dreamster/dreamster-board/shield-basic/shield-basic-BOM.xls

Reference | Qty | Value | Description | Digikey part number | Qty needed | Qty to buy | Cost | Total
 |  |  |  |  | 30
R6 | 1 | 10 | RES SMD 10 OHM 5% 0.4W 0805 | RHM10KDKR-ND | 30 | 30 | 0.05440 | 1.632
R7, R8, R10 | 3 | 100 | RES SMD 100 OHM 5% 1/8W 0805 | P100ACT-ND | 90 | 100 | 0.01490 | 1.490
L1, L2 L3 | 3 | 1 uH | FIXED IND 1UH 800MA 190 MOHM SMD | 490-4992-1-ND | 90 | 100 | 0.18330 | 18.330
C8 | 1 | 10 uF | CAP CER 10UF 16V 10% X5R 0805 | 490-3886-1-ND | 30 | 50 | 0.10380 | 5.190
C2, C4, C6, C9, C13, C14, C15 | 7 | 100 nF | CAP CER 0.1UF 16V 10% X7R 0805 | 399-1167-1-ND | 210 | 250 | 0.03000 | 7.500
R1, R2, R3, R9, R11, R12, R13 | 7 | 10k | RES SMD 10K OHM 5% 1/8W 0805 | P10KACT-ND | 210 | 250 | 0.01104 | 2.760
RV1, Rv2, Rv3 | 3 | 10k | TRIMMER 10K OHM 0.05W SMD | 490-6999-1-ND | 90 | 100 | 0.19050 | 19.050
C11 | 1 | 10n | CAP CER 10000PF 16V 10% X7R 0805 | 399-7995-1-ND | 30 | 50 | 0.11260 | 5.630
C1, C3 | 2 | 18n | CAP CER 0.018UF 50V 10% X7R 0805 | 399-1162-1-ND | 60 | 60 | 0.06460 | 3.876
R4, R5 | 2 | 2.2k | RES SMD 2.2K OHM 5% 1/8W 0805 | 1276-5537-1-ND | 60 | 100 | 0.00840 | 0.840
C10 | 1 | 2.2u | CAP CER 2.2UF 10V 10% X7R 0805 | 587-1286-1-ND | 30 | 50 | 0.06320 | 3.160
C12 | 1 | 220u | CAP ALUM 220UF 16V 20% SMD | 399-6679-1-ND | 30 | 30 | 0.29600 | 8.880
C5 | 1 | 3.3 uF | CAP CER 3.3UF 10V 10% X5R 0805 | 399-3129-1-ND | 30 | 50 | 0.11700 | 5.850
C7 | 1 | 47n | CAP CER 0.047UF 50V 10% X7R 0805 | 399-1166-1-ND | 30 | 50 | 0.03180 | 1.590
U5 | 1 | ARDUINO_SHIELD | CONN RCPT .100" |  | 30 |  |  | 0.000
D2 | 1 | CD1206-S01575 | DIODE GEN PURP 100V 150MA 1206 | CD1206-S01575CT-ND | 30 | 30 | 0.12880 | 3.864
P6, P7 | 2 | CONN_01X02 | CONN HEADER .100 2POS |  | 60 |  |  | 0.000
P1, P2, P3, P4, P5 | 5 | CONN_01X04 | CONN RCPT .100" |  | 150 |  |  | 0.000
P8 | 1 | CONN_01X06 | CONN RCPT .100" |  | 30 |  |  | 0.000
IC1 | 1 | DRV8833 | IC MOTOR DRIVER PAR 16HTSSOP | 296-29434-1-ND | 30 | 30 | 2.20600 | 66.180
D1 | 1 | LED_RGB_A | LED RED/GREEN/BLUE PLCC6 SMD | CLV6A-FKB-CK1P1G1BB7R3R3TR-ND | 30 | 30 | 0.75000 | 22.500
U2 | 1 | LM386 | IC AMP AUDIO PWR .325W AB 8VSSOP | LM386MMX-1/NOPBCT-ND | 30 | 30 | 0.78800 | 23.640
Q2 | 1 | NPN | Transistors_SMD:sot23 |  | 30 |  |  | 0.000
Q1 | 1 | PNP | Transistors_SMD:sot23 |  | 30 |  |  | 0.000
CON1 | 1 | SD_Card | CONN SD CARD PUSH-PUSH R/A SMD | DM1AA-SF-PEJ(21) | 30 | 30 | 3.41240 | 102.372
P9 | 1 | speaker | CONN HEADER .100 2POS |  | 30 | 30 |  | 0.000
SW1 | 1 | SW_PUSH | SWITCH PUSH SPST-NO 0.1A 32V | 401-1985-ND | 30 | 30 | 0.73000 | 21.900
U3, U4 | 2 | TCRT1000 | SENSOR OPTO TRANS 4MM REFL THPCB | 751-1031-ND | 60 | 60 | 0.73480 | 44.088
U1, U19 | 2 | TL082 | IC OPAMP JFET 3MHZ 8SOIC | 296-1284-1-ND | 60 | 60 | 0.51040 | 30.624
 |  |  |  |  |  |  | Total amount to pay | 400.946
 |  |  |  |  |  |  | Total per board | 13.365
