dreamster/dreamster-board/shield-basic/shield-basic.kicad_pcb

## KiCad design shield-basic/shield-basic.kicad_pcb (2015-02-26)

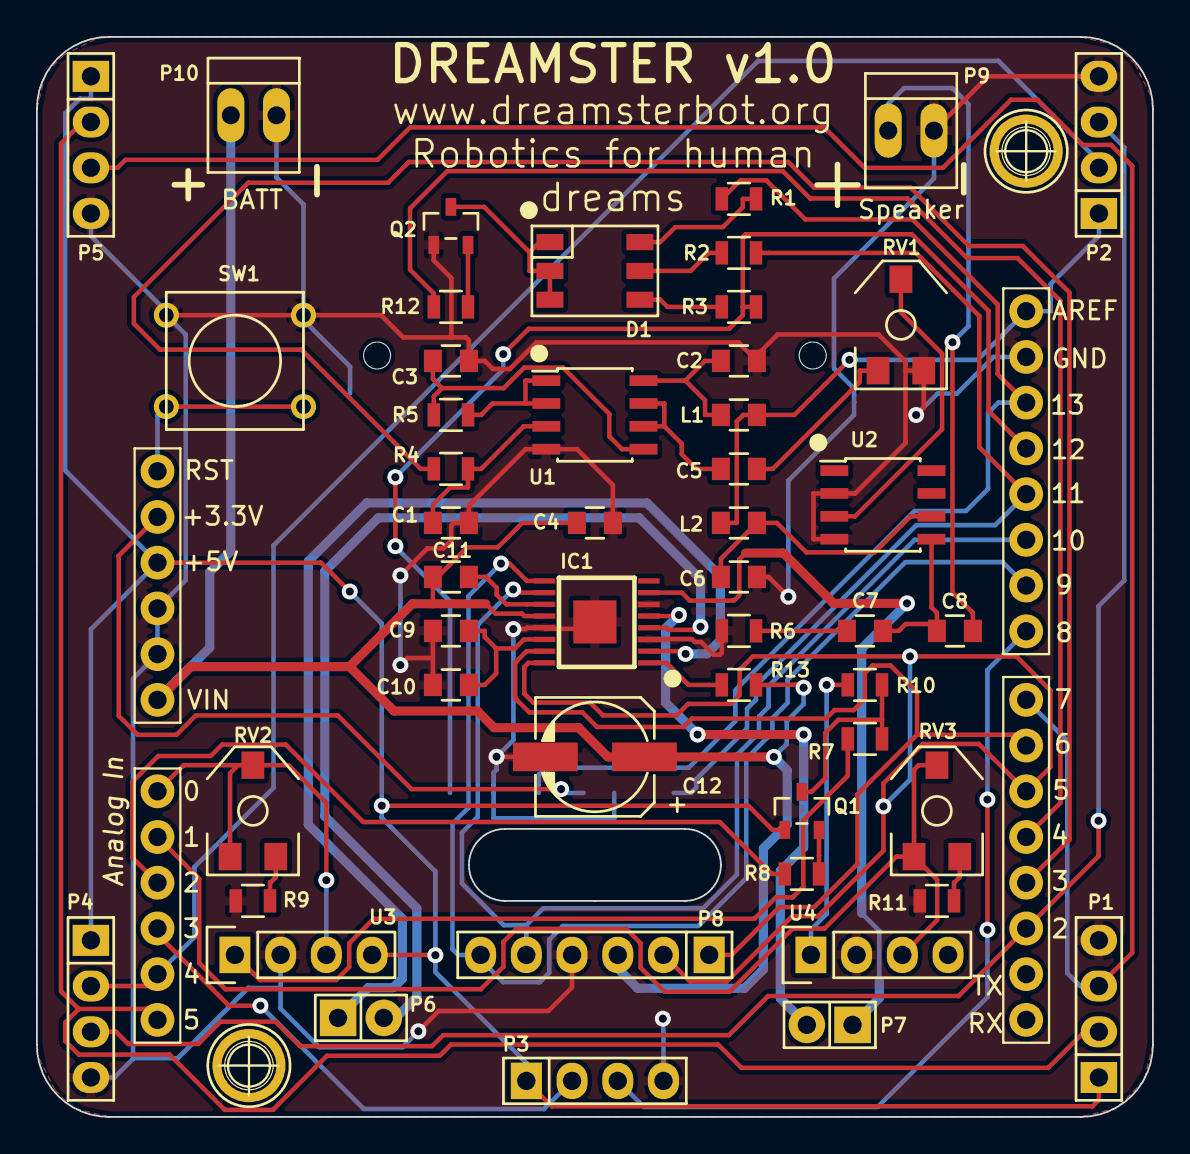
[picture p1: board shield-basic.kicad_pcb from above]

Board: 2 copper layers, 62.0 x 60.0 mm, 53 parts (1 on the bottom side), 52 nets.

Parts:
C1, C3: 18n; C_0805
C2, C6: 100 nF; C_0805
C4, C9: 100n; C_0805
C5: 3.3 uF; C_0805
C7: 47n; C_0805
C8: 10 uF; C_0805
C10: 2.2u; C_0805
C11: 10n; C_0805
C12: 220u; c_elec_6.3x7.7
CON1: SD_Card; SD_Card_Receptacle
D1: LED_RGB_A; rgb_led_plcc6
IC1: DRV8833; drv8833
L1, L2: 1 uH; C_0805
P1, P2, P3, P4, P5: CONN_01X04; Socket_Strip_Straight_1x04
P6, P7: CONN_01X02; Socket_Strip_Straight_1x02
P8: CONN_01X06; Socket_Strip_Straight_1x06
P9: Speaker; PINHEAD1-2
P10: CONN_01X02; PINHEAD1-2
P11, P12: CONN_01X01; 1pin
Q1: BC857; sot23
Q2: BC847; sot23
R1, R2, R3, R12: 10k; R_0805
R4, R5: 2.2k; R_0805
R6: 10; R_0805
R7, R8, R9, R10, R11: 100; R_0805
R13: 47k; R_0805
RV1, RV2, RV3: 10k; POT_SMD
SW1: SW_PUSH; SW_PUSH_SMALL
U1: TL082; SOIC-8_3.9x4.9mm_Pitch1.27mm
U2: LM386; SOIC-8_3.9x4.9mm_Pitch1.27mm
U3, U4: TCRT1000; Socket_Strip_Straight_1x04
U5: ARDUINO_SHIELD; arduino_shield

Connections:
+3V3: CON1.4, U5.3.3V
+5VD: L1.1, L2.1, P1.1, P2.1, P3.1, P4.1, P5.1, Q1.1, U3.4, U4.4, U5.5V, U5.AREF
+BATT: C4.1, C11.2, C12.1, IC1.12, P8.3, P10.1, R13.1, U5.VIN
/BLUE: CON1.5, R1.1, U5.D13
/ECHO_A: P3.3, U5.D8
/ECHO_B: P2.3, P4.3, U5.D2
/ECHO_C: P1.3, P5.3, U5.D7
/GREEN: CON1.2, R2.1, U5.D11
/LED_enable: R12.1, U5.D4
/RED: CON1.7, R3.1, U5.D12
/RESET: SW1.1, U5.RES
/TRG_A: P3.2, U5.A3
/TRG_B: P2.2, P4.2, U5.A4
/TRG_C: P1.2, P5.2, U5.A5
/hbridge/LM+: IC1.7, P7.1
/hbridge/LM-: IC1.5, P7.2
/hbridge/LMI1: IC1.9, P8.6, U5.D9
/hbridge/LMI2: IC1.10, P8.5, U5.D10
/hbridge/RM+: IC1.2, P6.1
/hbridge/RM-: IC1.4, P6.2
/hbridge/RMI1: IC1.16, P8.2, U5.D5
/hbridge/RMI2: IC1.15, P8.1, U5.D6
/irsensor/LSENS: RV2.1, RV2.2, U3.3, U5.A0
/irsensor/RSENS: RV3.1, RV3.2, U4.3, U5.A1
/irsensor/~EMITTER: R8.2, U5.A2
/sound/In: R4.2, U5.D3
GND: C1.2, C2.2, C3.2, C4.2, C6.2, C9.2, C10.2, C12.2, CON1.3, CON1.6, CON1.12, CON1.13, IC1.3, IC1.6, IC1.13, P1.4, P2.4, P3.4, P4.4, P5.4, P8.4, P9.2, P10.2, Q2.1, R6.2, R9.2, R11.2, RV1.3, SW1.2, U1.4, U2.2, U2.4, U3.2, U4.2, U5.GND@
unnamed: C1.1, R4.1, U1.3
unnamed: C2.1, L1.2, U1.8
unnamed: C3.1, R5.1, U1.5
unnamed: C5.1, U1.6, U1.7
unnamed: C5.2, RV1.1
unnamed: C6.1, L2.2, U2.6
unnamed: C7.1, C8.1, U2.5
unnamed: C7.2, R6.1
unnamed: C8.2, P9.1
unnamed: C9.1, C10.1, IC1.14
unnamed: C11.1, IC1.11
unnamed: D1.1, D1.2, D1.3, Q2.3
unnamed: D1.4, R3.2
unnamed: D1.5, R2.2
unnamed: D1.6, R1.2
unnamed: IC1.1, R13.2
unnamed: Q1.2, R8.1
unnamed: Q1.3, R7.1, R10.1
unnamed: Q2.2, R12.2
unnamed: R5.2, U1.1, U1.2
unnamed: R7.2, U3.1
unnamed: R9.1, RV2.3
unnamed: R10.2, U4.1
unnamed: R11.1, RV3.3
unnamed: RV1.2, U2.3
