dreamster/dreamster-board/(threads)

Thread 1 (2015-01-26):

Switch to DRV8833C h bridge

yagui, 2015-01-26:
Check the schematics of www.bananarobotics.com module and find out what's the porpoise of serverl resistor and capacitors. Check if they are needed in dreamster-shield.

tulku, 2015-02-07:
This one depends on #5.

tulku, 2015-02-07:
In #5 we decided to switch to the DRV8833C h bridge. I'm updating this issue to reflect that.

Closed 2015-02-23.

Thread 2 (2015-01-26):

Check TCR1000 in dreamster-shield

yagui, 2015-01-26:
Check the connections of TCR1000 on dreamster-shield schematic. It was copied from CdR Tito project. Discuss how it works and if there is no missing components

Martin-MT, 2015-02-02:
I believe there are no missing components.
It only needs a resistor to generate a voltage proportional to the current going through the phototransistor

Closed 2015-02-02.

Thread 3 (2015-02-06):

Add RGB leds to the board

tulku, 2015-02-06:
We wanted to have some LEDs to allow easily debugging.

We thought of having LEDs in parallel to save pins but still have enough lights to make it nice.

yagui, 2015-02-07:
any suggestion? I don't know any popular RGB led

tulku, 2015-02-07:
@sebascerone can we re use the LED that we use in LESS boards? Which one is it?

sebascerone, 2015-02-07:
I don't think so, digikey just send me an email tell me it is deprecated.
Why don'y we use just SMD LED?

Regards,
Sebastian

2015-02-07 14:48 GMT-03:00 tulku <notifications@github.com>:

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

tulku, 2015-02-07:
I don't understand... I guess that Ariel wants the specific LED so that he
can check currents, and connections... And not just if it is SMD or DIP...

"Oh no, not again."

- A bowl of petunias on its way to certain death.

On Sat, Feb 7, 2015 at 2:54 PM, sebascerone <notifications@github.com>
wrote:

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

Closed 2015-02-23.

Thread 4 (2015-02-06):

Add sound to dreamster

tulku, 2015-02-06:
Having sound could be nice. In the current dream-sheild version, can we easily add something to reproduce sounds (like human voice, recorded mp3s)?

Please take into account that we can just hack one or two robots and not add sound to all the robots.

tulku, 2015-02-07:
To add audio, we could put an stereo audio codec and an SD reader. We don't need to decode MP3, that circuito wouldn't be so complex nor expensive.

Something like this could be use to read the SD:
https://learn.adafruit.com/adafruit-micro-sd-breakout-board-card-tutorial

And something like this to use as Stereo Audio CODEC:
http://ar.mouser.com/Search/Refine.aspx?Keyword=WM8731

There is a board from which we can copy schematics and library:
https://www.sparkfun.com/products/11290
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

The board seems to be based in this project: http://wiki.openmusiclabs.com/wiki/AudioCodecShield

tulku, 2015-02-07:
It seems, according to @ernestmc that the output power of this IC will not drive a speaker. We should add some aplification stage to make it louder.

yagui, 2015-02-07:
I dont understand what is the goal.

We want to add sound to some boars but not all?
It should be in the dreamster shield schematics and we solder it just in a few? or is an extra board that we could add in some prototypes?

We want microphone AND recorded sound? or is one or the other.

If we gonna put an SD, I wouldn't use a codec. I'd just save raw sound, and simplify the circuit.

tulku, 2015-02-07:
If we can make it simple and cheap enough it would be nice to put it on every board, if not just a few.

I think that having the footprints in the board and use them or not is better than having an add on board.

I like your idea... Just store the samples in the SD, output PWM, filter and then use a simple amplifier?

Could you add that to the schematics?

yagui, 2015-02-14:
if we use a SD card we need 4 pins for spi. Do we have other options?

tulku, 2015-02-15:
I don't think so. We do not have those pins?

"Oh no, not again."

- A bowl of petunias on its way to certain death.

On Sat, Feb 14, 2015 at 12:56 PM, Ariel Burman <notifications@github.com>
wrote:

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

yagui, 2015-02-16:
we are one pin short.
maybe we can leave the ir sensor's leds always on.

tulku, 2015-02-16:
@Martin-MT thought that this was a bad idea, but I don't remember why.

yagui, 2015-02-16:
ok, we can share a pin. The leds enable of ir sensors and mosi (cmd) line of the sd. When using the ir sensors the ChipSelect line of the sd should be disabled. When using the SD, the led of ir sensor will flash randomly. If we do not make readings of the sensors while using the SD, I think it will be ok. What do you think?

ernestmc, 2015-02-16:
Just one word: BUS. Make the IR sensors and all other sensors work independently with a small dedicated uP that magages the polling on pogrammable intervals or otherwise. Another benefit of this approach is that you can make them separate pluglable modules.

yagui, 2015-02-16:
It's getting complicated. I think this first version should be simple. What if we forget about the SD card and generate simple sounds like tones?

tulku, 2015-02-16:
Ok. I like the idea of sharing the Pin. We will not have an sd reader per
robot, so we will be generating tones for most of them. In the ones that we
want to have proper sounds, we can share the pin.

Lucas

"Oh no, not again."

- A bowl of petunias on its way to certain death.

On Mon, Feb 16, 2015 at 1:35 PM, Ariel Burman <notifications@github.com>
wrote:

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

Closed 2015-02-23.

Thread 5 (2015-02-07):

Do we want to use the L9110 h bridge?

tulku, 2015-02-07:
The H-bridge present in the most common "arduino driver for motors" is the L9110. That IC is no were to be found, execpt in Alibaba, where it is incredible cheap:

http://www.alibaba.com/product-detail/L9110-L9110S_60135131276.html

@yagui, @sebascerone Will we be able to source the components? Shall we use a more trusty part? Switch to a TI h bridge?

sebascerone, 2015-02-07:
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
We should use LMD18200 from TI. It is the same I used for TCO.

Regards,
Sebastian

yagui, 2015-02-07:
DRV8833C looks about similar to L9110 and is one of the least expensive in ti webpage
http://www.ti.com/product/DRV8833C
$2.24 or $0.8 | 1ku

LMD18200 has more output current, it says 12V operation, and is more expensive
$17.01 or $8.10 | 1ku
www.ti.com/product/LMD18200
If we want more current rate there other options in ti web
http://www.ti.com/product/drv8848
is a good option or
http://www.ti.com/product/drv8841
another one

sebascerone, 2015-02-07:
Forget LMD 18200, it is a lot of money!!!

2015-02-07 10:33 GMT-03:00 Ariel Burman <notifications@github.com>:

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

tulku, 2015-02-07:
@sebascerone  what do you thing, DRV8833C or L9110? The TI one seems cheap enough and I would think that it's more reliable.

sebascerone, 2015-02-07:
I always prefer texas than a chinese IC.

2015-02-07 14:52 GMT-03:00 tulku <notifications@github.com>:

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

tulku, 2015-02-07:
Ok, then we switch to the DRV8833C.

Closed 2015-02-07.

Thread 10 (2015-02-23):

connector for h-bridge replacement

yagui, 2015-02-23:
The connector 6 is for when one want to use the Chinese L9110 h-bridge.
In that case, I think the actual position puff the connector hides a trimmer.
The connector can be moved a little too the right.

yagui, 2015-02-23:
also should be checked that is correctly oriented, or if it should be rotated 180 degrees

yagui, 2015-02-23:
the orientation its ok. no need to rotate.

Closed 2015-02-25.

Thread 6 (2015-02-23):

Gnd plane

yagui, 2015-02-23:
The h-bridge needs a Gnd plane for heat dissipation.
Bottom plane could be 5V, making a big capacitor and helping stability of power

Closed 2015-02-25.

Thread 7 (2015-02-23):

Connector battery

yagui, 2015-02-23:
The connector for the battery ( P10 ) should be in the edge of the pcb, in case the battery goes below the two boards

yagui, 2015-02-23:
maybe we can move the switch a little down and put this connector where is the switch now

Closed 2015-02-24.

Thread 11 (2015-02-24):

Connectors for ultrasound too close

yagui, 2015-02-24:
It seems that the hcsr-04 has 45 mm width.
http://s442.photobucket.com/user/supperman2000/media/BGA/Module%20HC-SR04/3.jpg.html
http://www.robosoftsystems.co.in/wikidocs/images/archive/8/84/20130108065629!HC-SR04.jpg

If is this correct:

- P1 and P2 (P4 and P5) should be separated at least 45 mm (47m or more is preferred) measured  from both center of pin 1. Now is 43 mm.

- P1 and P4 should be separated 45 mm measured from internal edge of the connector. Now is 38 mm.

Closed 2015-02-24.

Thread 12 (2015-02-24):

Led blocked by L9110

yagui, 2015-02-24:
In case of using L9110 (33 mm height, 20 mm width) the led will be blocked.
The led should be moved 14 mm higher.

yagui, 2015-02-24:
http://bestaccessories.info/l9110-2-channel-motor-driver-module-red-green-2-5~12v_643042.html

yagui, 2015-02-24:
Also P6 could be moved a little more to the right

Closed 2015-02-25.

Thread 15 (2015-02-25):

H-bridge power pad

yagui, 2015-02-25:
there shouldn't  be any track or via under h-bridge. It should be all Gnd plane. Tracks should come outward  of the ic.

Closed 2015-02-25.

Thread 16 (2015-02-25):

led serigraphy

yagui, 2015-02-25:
Fix Led serigraphy, so the pads don't be covered by it

Closed 2015-02-25.

Thread 17 (2015-03-25):

holes position

sebasgm, 2015-03-25:
More space for the holes is required in order to easily attach hte battery holder and the chassis.

Thread 18 (2015-03-25):

Preset footprint

sebasgm, 2015-03-25:
The preset footprint for light sensors doesn't match the physical component.

Thread 19 (2015-03-25):

LM386 footprint

sebasgm, 2015-03-25:
LM 386 footprint doesn't match the physical component.

Thread 20 (2015-03-25):

SD card holder footprint

sebasgm, 2015-03-25:
The footprint doesn't match the physical component. Some pins match but others don't and it is not so easy to figure out which is which.

Thread 22 (2015-04-08):

Power Switch

nachocarballeda, 2015-04-08:
ENG: It would be good to have 2 pins to pull a on/off switch in the robot case.
ESP: Estaría bueno tener dos pines en la placa para poder usar un switch que encienda/apague el robot. (Esto evita tener que sacar los cables de la batería para apagarlo)

garyservin, 2015-04-30:
:+1:

Thread 23 (2015-04-08):

More pins

nachocarballeda, 2015-04-08:
To avoid errors by users of the dreamboard, i recommend adding pins to fill all outputs / inputs from the Arduino to the board.

Thread 24 (2015-04-30):

Add Wifi modules

sebasgm, 2015-04-30:
Could it be a nice to have in terms of avoiding the need of a rPI for having wireless communication?

Which module should we use? Is it expensive?

We have to answer these questions for making a decision.

garyservin, 2015-04-30:
The most inexpensive module is the ESP8266. It costs ~3 USD (I bought them for 2.69 in 20 qty from USA) and comes in a variety of packages.

I think it is the best option if we want to keep the robot cheap.

tulku, 2015-04-30:
And we already have experience using it. I would go with it.

I'm not sure if we want it in the RPI capable version of dreamster.
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

Thread 25 (2015-04-30):

Add some form of encoder/odometry

garyservin, 2015-04-30:
This is not strictily related to the board but...

If we want to use ROS with the robot, it's mandatory that we have some sort of odometry for the wheels.

One option is to use accelerometers and integrate (x2) the readings to obtain position, but I think that is not such a good Idea

We can use a simple [magnet](https://www.pololu.com/product/2599) with a Hall efect sensor.

We can also add a gyro in order to help with the error when the robot is turning (e.g. like in the turtlebot).

tulku, 2015-04-30:
We need odometry and would add the gyro also. Good odometry is necessary
and getting it just with encoders is very expensive.

Lucas
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

Thread 26 (2015-05-25):

RGB led Red pin no PWM

ernestmc, 2015-05-25:
The Red pin of the RGB led is attached to pin 12 of the Arduino Leonardo but that pin doesn't support PWM modulation, hence that color cannot be controlled. This should be reviewed in future versions.
