dreamster/dreamster-board/(commit log)

2014-10-10 Initial commit, some spec defined.
    [dreamster.sch]
2014-11-22 Add USB and Power schematics taken from ArduinoUno
    These are taken from the Kicad version of the Arduino Uno rev3 project.
    [dreamster.sch, power.sch, usb.sch]
2015-01-26 first version of dreamster-shield (work in progress)
    [shield-basic.sch]
2015-02-14 Added sound and completed irsensor
    [irsensor.sch, shield-basic.sch, sound.sch]
2015-02-14 Removed unused libraries from kicad project
    [irsensor.sch, shield-basic.sch, sound.sch]
2015-02-16 Organizo el puente h y agrego la sd. faltaria comfirmar que la asignacion de pines es adecuada y que no falten componentes. Se puede empezar con el pcb
    [hbridge.sch, irsensor.sch, shield-basic.sch, sound.sch]
2015-02-20 shield-basic schematics almost finished. starting pcb
    [hbridge.sch, irsensor.sch, shield-basic.kicad_pcb, shield-basic.sch, sound.sch]
2015-02-22 update on cmp
    [irsensor.sch]
2015-02-22 updated on schematics and footprints
    [hbridge.sch, irsensor.sch, shield-basic.sch, sound.sch]
2015-02-22 Place the components in the Board. Change some footprint because kicad will remove the library.
    [hbridge.sch, irsensor.sch, shield-basic.kicad_pcb, shield-basic.sch, sound.sch]
2015-02-22 Change the board size
    [shield-basic.kicad_pcb, sound.sch]
2015-02-22 Added reset buttom.
    [shield-basic.kicad_pcb, shield-basic.sch]
2015-02-22 Correct HCS04 sensor position.
    [shield-basic.kicad_pcb]
2015-02-22 Correct LED RGB position.
    [hbridge.sch, irsensor.sch, shield-basic.kicad_pcb, shield-basic.sch]
2015-02-22 PCB routed.
    [shield-basic.kicad_pcb]
2015-02-22 Added BOM.
    [shield-basic-BOM.xls]
2015-02-23 fix some issues on schematic
    [hbridge.sch, irsensor.sch, shield-basic.sch, sound.sch]
2015-02-23 The board is routed again, to fix some problems.
    [irsensor.sch, shield-basic.kicad_pcb]
2015-02-24 Fix: #6 Add Gnd Plane. Fix: #9 Change IR footprint. Fix: #10 Move the trimmer, the orientation is ok.
    [shield-basic.kicad_pcb]
2015-02-24 finished h-bridge and updated some values
    [hbridge.sch, irsensor.sch]
2015-02-24 Added footprint for R13
    [hbridge.sch]
2015-02-24 Fix #7: The connector was move to the board edge. Fix #8: Added a hole for the wires. Fix #11: The board now is bigger to get the at the proper distance. Fix: #12: Now the LED won't be covered by the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
    [shield-basic.kicad_pcb]
2015-02-24 Change the slogan in the board.
    [shield-basic.kicad_pcb]
2015-02-25 Fix #13: The capacitor was moved next to the IC Fix #14: I added both simbols Fix #15: I add power pad. Fix #16
    [shield-basic.kicad_pcb, shield-basic.sch]
2015-02-26 Fixed some minor issues
    [shield-basic.kicad_pcb]
2015-02-26 fixed some marks and cetered pcb
    [shield-basic.kicad_pcb]
